AlwaysAbia/senior-project-freeuni/3d-models/JPEGs/BotPartCollapsed.JPG

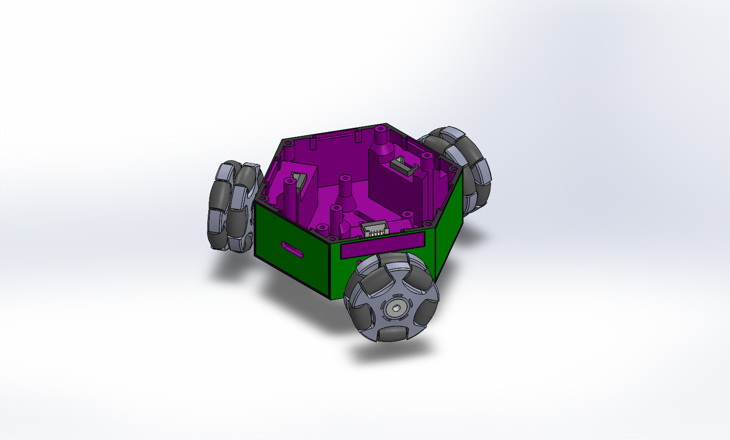
3d-models/JPEGs/BotPartCollapsed.JPG
