AlwaysAbia/senior-project-freeuni/3d-models/JPEGs/MidPartCollapsed.JPG

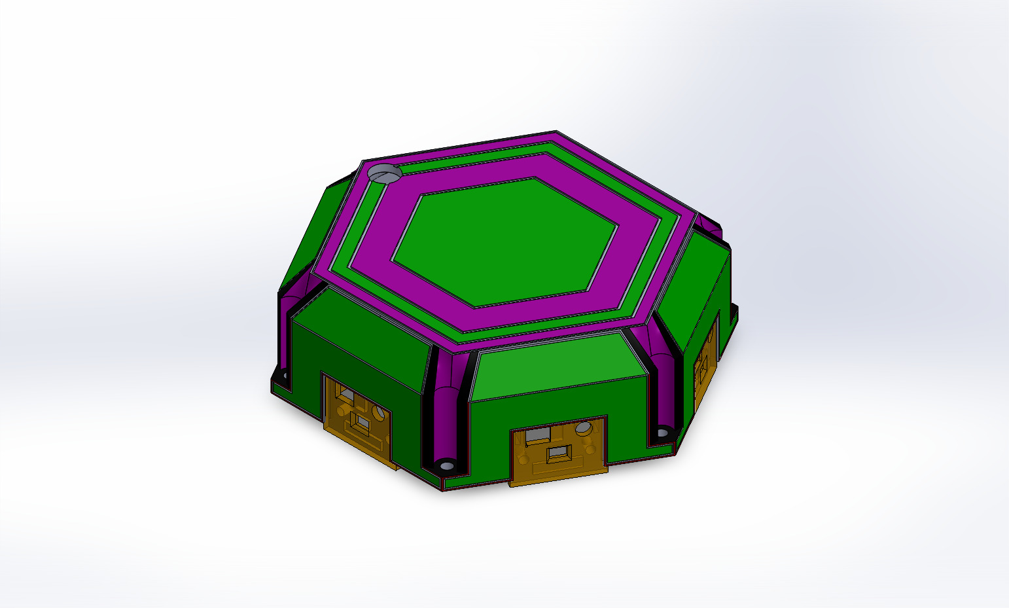
3d-models/JPEGs/MidPartCollapsed.JPG
