AlwaysAbia/senior-project-freeuni/3d-models/JPEGs/MidPartExploded.JPG

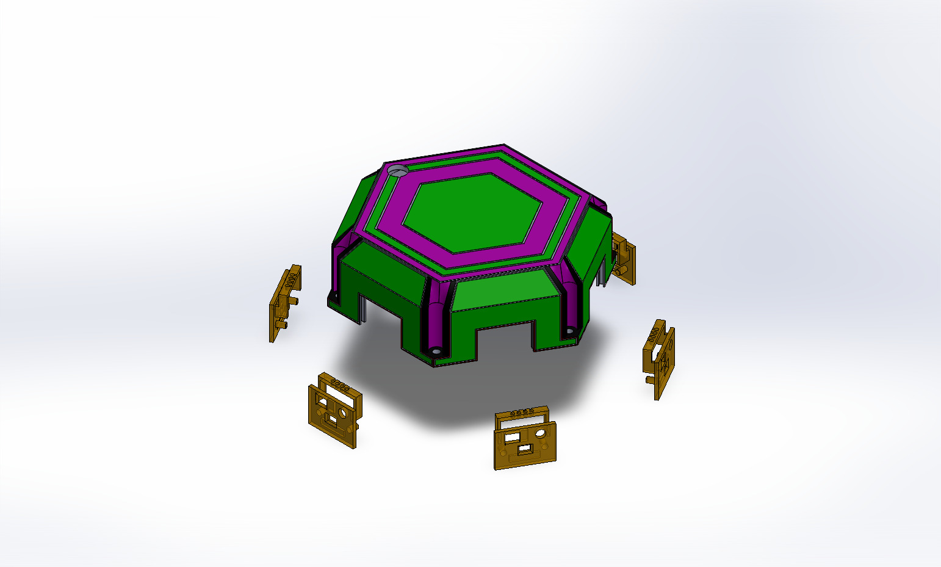
3d-models/JPEGs/MidPartExploded.JPG
