AlwaysAbia/senior-project-freeuni/3d-models/JPEGs/SensorModuleBotSide.JPG

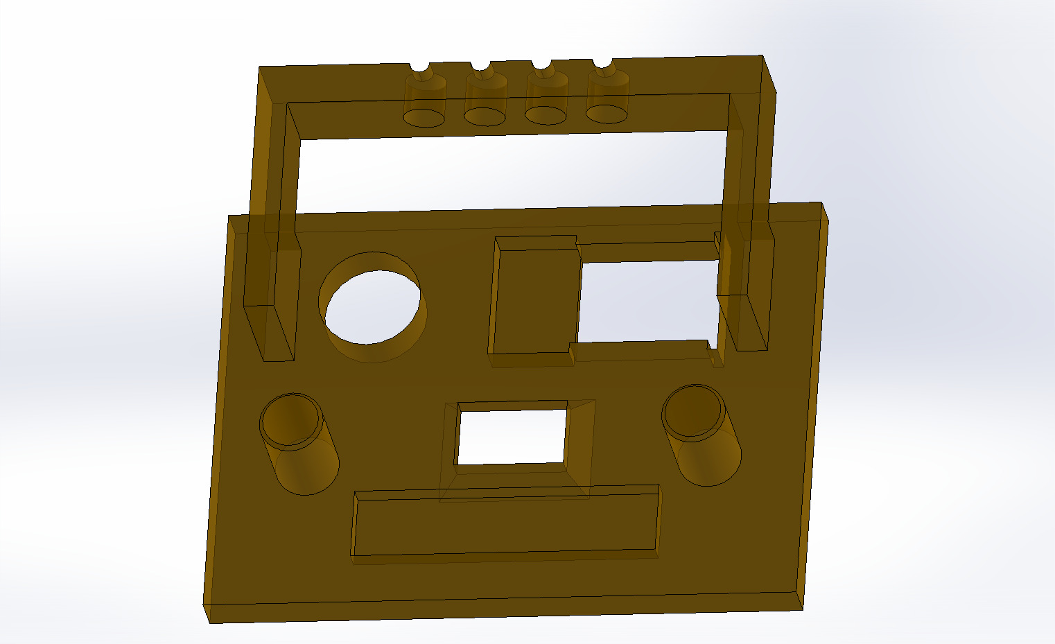
3d-models/JPEGs/SensorModuleBotSide.JPG
