AlwaysAbia/senior-project-freeuni/3d-models/JPEGs/SensorModuleTopSide.JPG

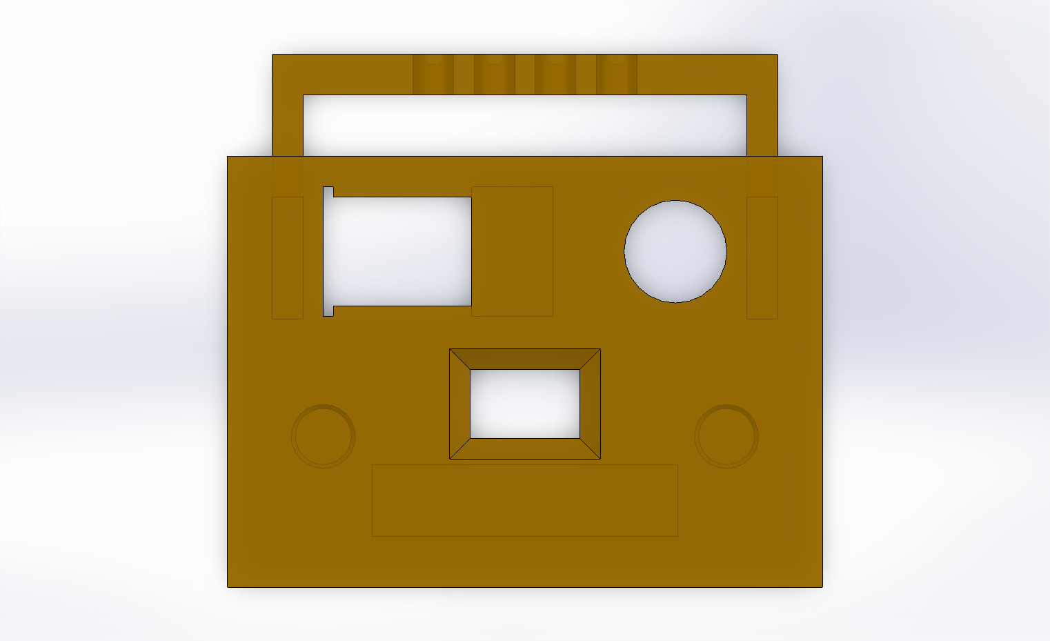
3d-models/JPEGs/SensorModuleTopSide.JPG
