AlwaysAbia/senior-project-freeuni/3d-models/FinalModels/MidPart.SLDPRT

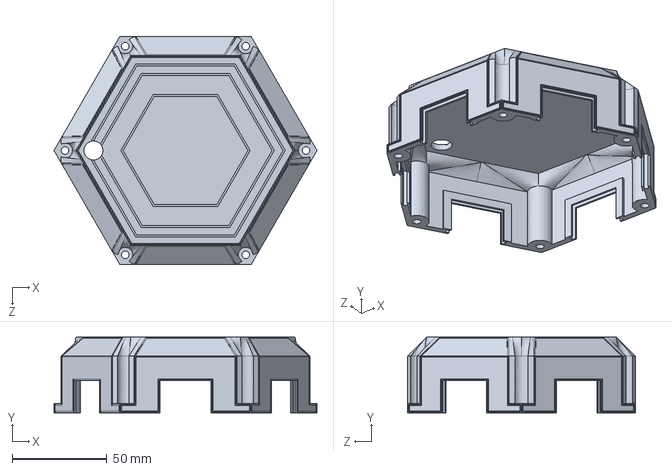
[picture p22: CAD file, 2025-06-16]
3d-models/FinalModels/MidPart.SLDPRT
138.6 x 40.0 x 120.0 mm
