AlwaysAbia/senior-project-freeuni/3d-models/FinalModels/SensorModule.SLDPRT

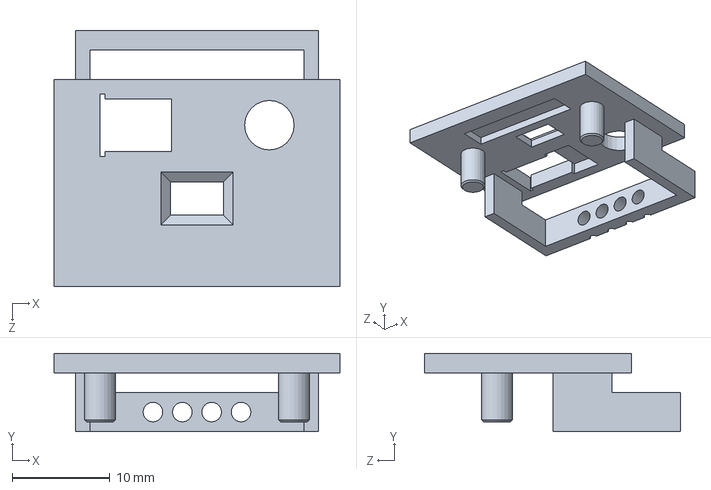
[picture p23: CAD file, 2025-06-16]
3d-models/FinalModels/SensorModule.SLDPRT
29.2 x 8.00 x 26.2 mm
