AlwaysAbia/senior-project-freeuni/3d-models/FinalModels/BotPartSTL.STL

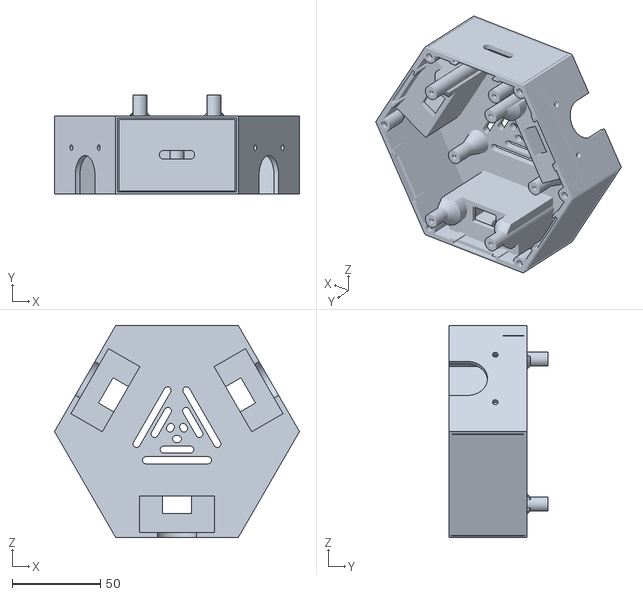
[picture p24: CAD file, 2025-06-16]
3d-models/FinalModels/BotPartSTL.STL
138.6 x 56.0 x 120.0
