AlwaysAbia/senior-project-freeuni/3d-models/FinalModels/TopPart.SLDPRT

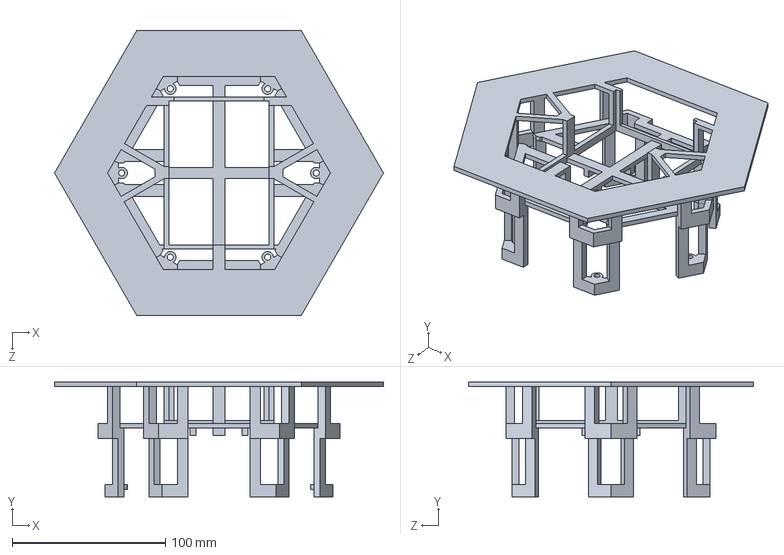
[picture p25: CAD file, 2025-06-16]
3d-models/FinalModels/TopPart.SLDPRT
214.8 x 75.0 x 186.0 mm
