AlwaysAbia/senior-project-freeuni/(list of files, cad)

Other CAD files:
3d-models/FinalModels/ModuleSTL.STL
3d-models/FinalModels/BotPart.SLDPRT
3d-models/FinalModels/MidPartSTL.STL
3d-models/FinalModels/TopPartSTL.STL
