AlwaysAbia/senior-project-freeuni/3d-models/JPEGs/FullAssemblyCollapsed.JPG

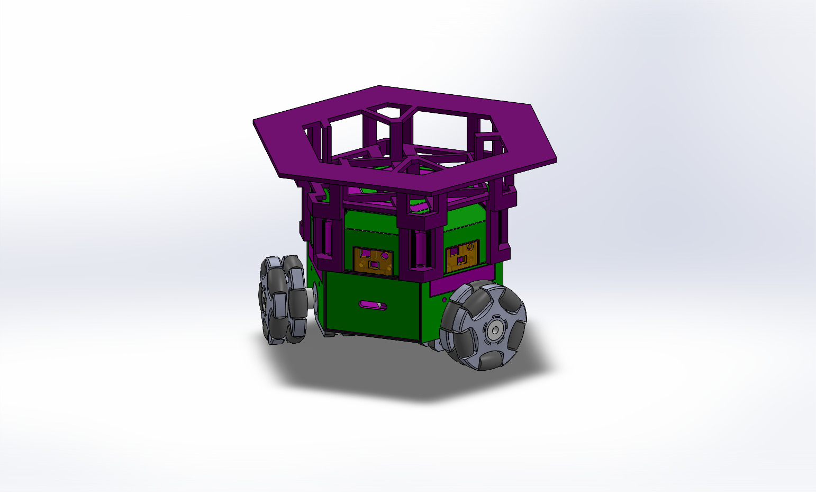
3d-models/JPEGs/FullAssemblyCollapsed.JPG
