AlwaysAbia/senior-project-freeuni/3d-models/JPEGs/FullAssemblyExploded.JPG

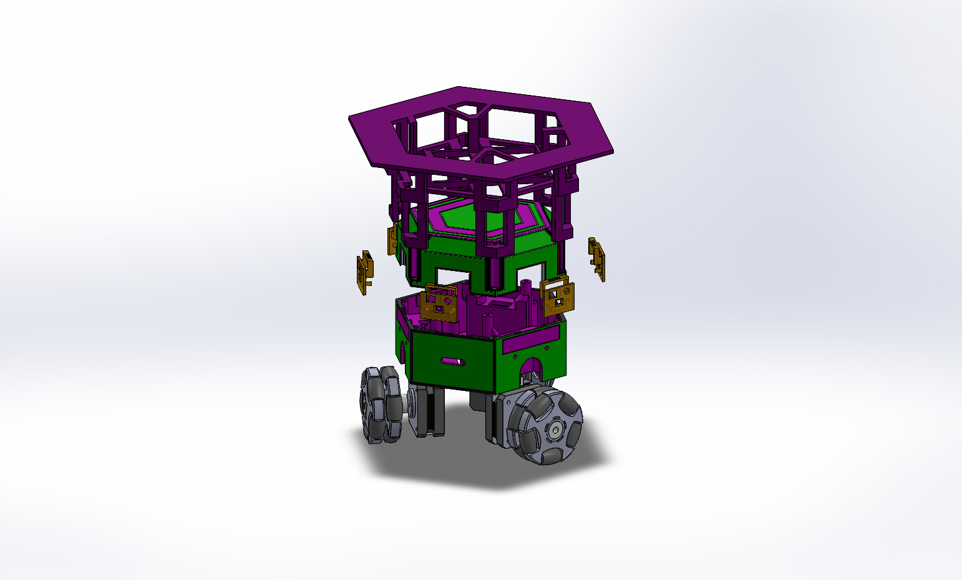
3d-models/JPEGs/FullAssemblyExploded.JPG
