AlwaysAbia/senior-project-freeuni/schematics-and-pcb/MainPCB/Schematic.pdf

IO12 20 IO13 21 IO14 22 IO21 23 IO47 24 IO48 25 IO45 26 IO0 27 IO35 28 IO36 29 IO37 30 IO38 31 IO39 32 IO40 33 IO41 34 IO42 35 RXD0 36 TXD0 37 IO2 38 IO1 39 GND 40 GND ⁴¹

# GNDESP_3V³

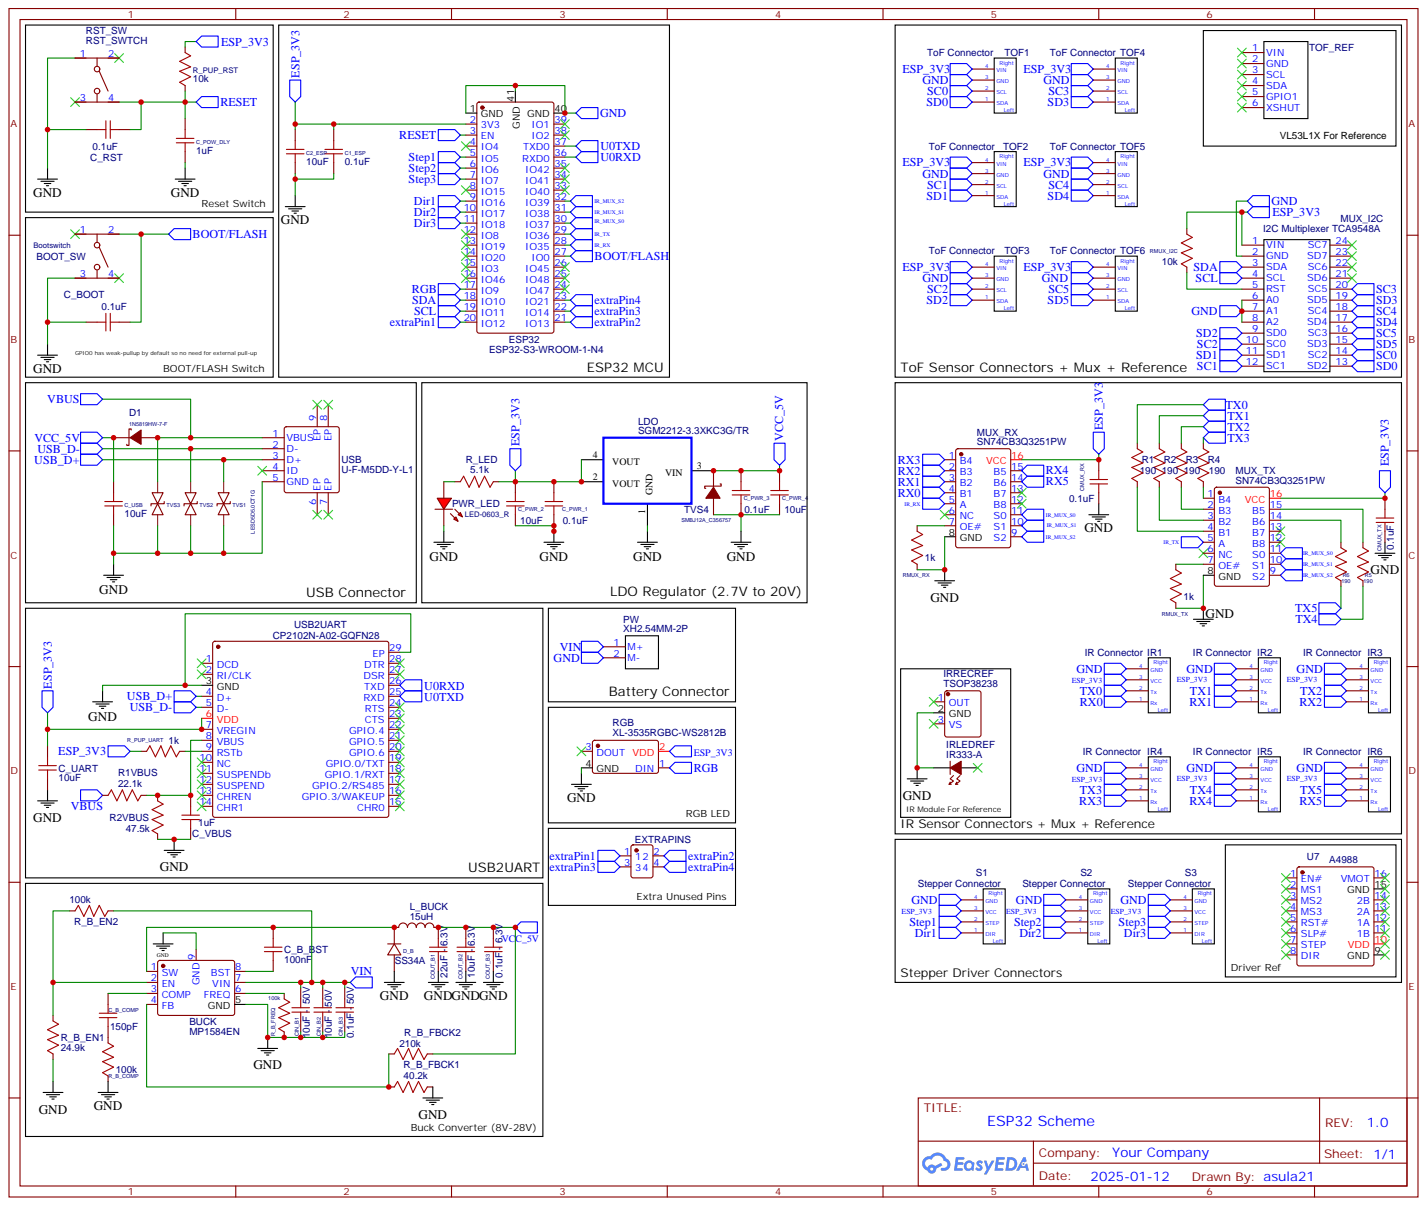
[picture p28: page 1]

GPIO0 has weak-pullup by default so no need for external pull-up

ToF Sensor Connectors + Mux + Reference

GND
IR Module For Reference
IR Sensor Connectors + Mux + Reference
