AlwaysAbia/senior-project-freeuni/schematics-and-pcb/MainPCB/PCB_Layout.pdf

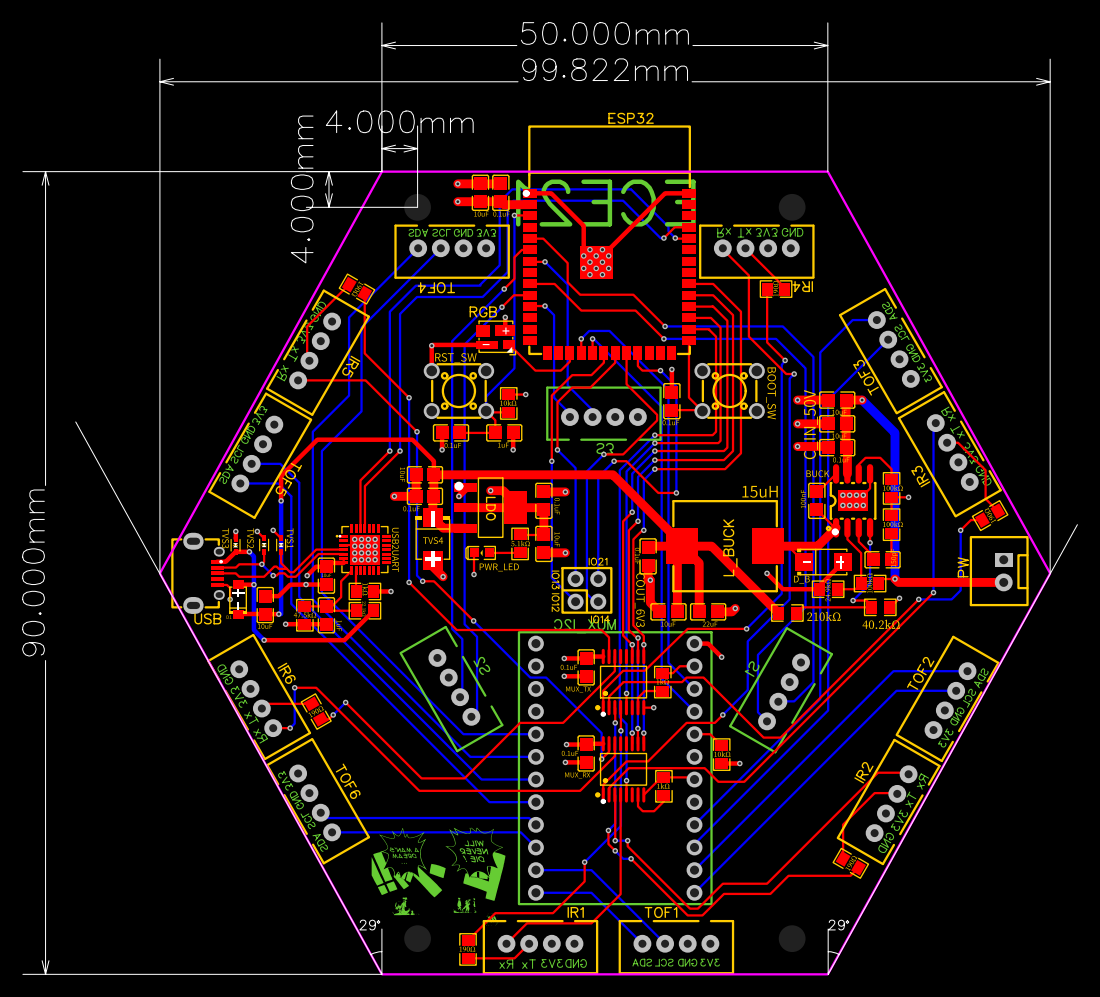
[picture p29: page 1]

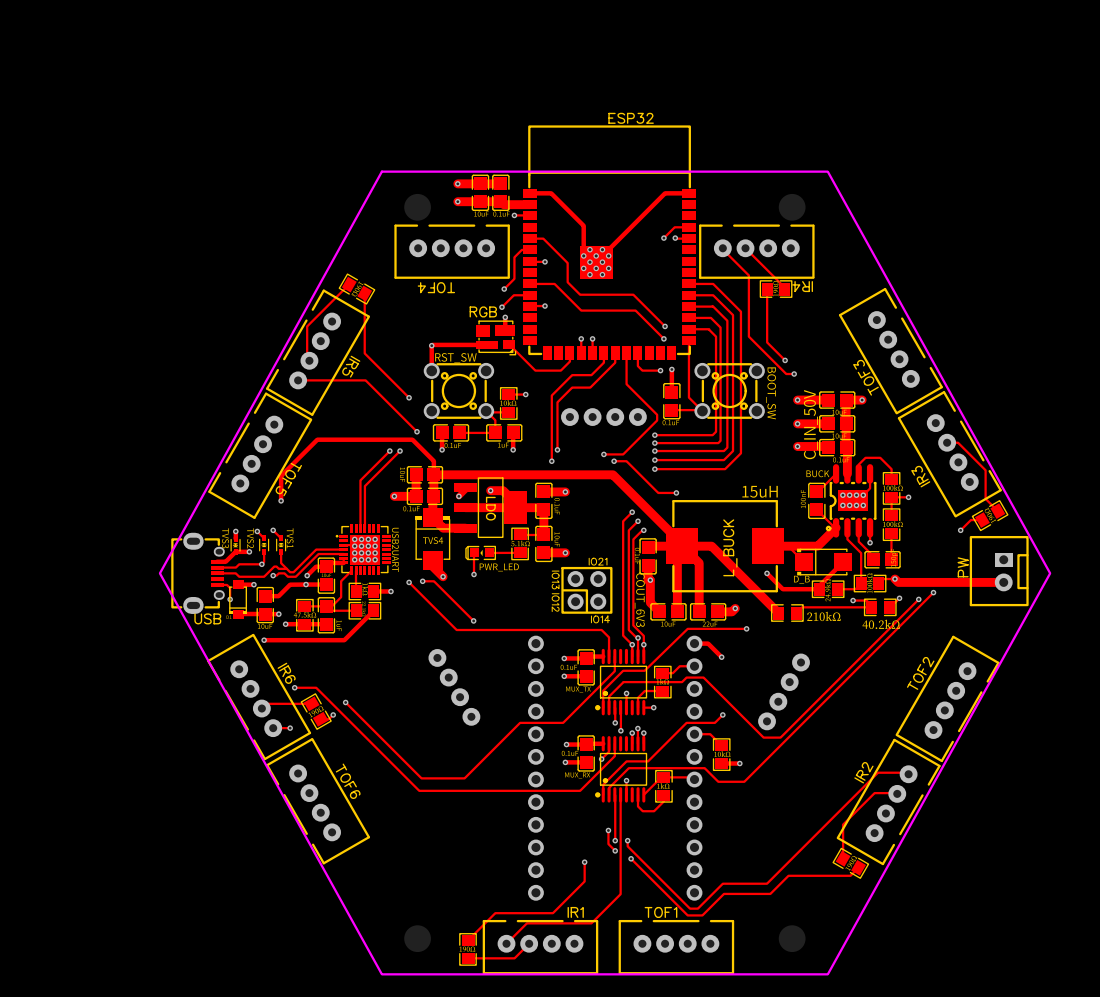
[picture p30: page 2]

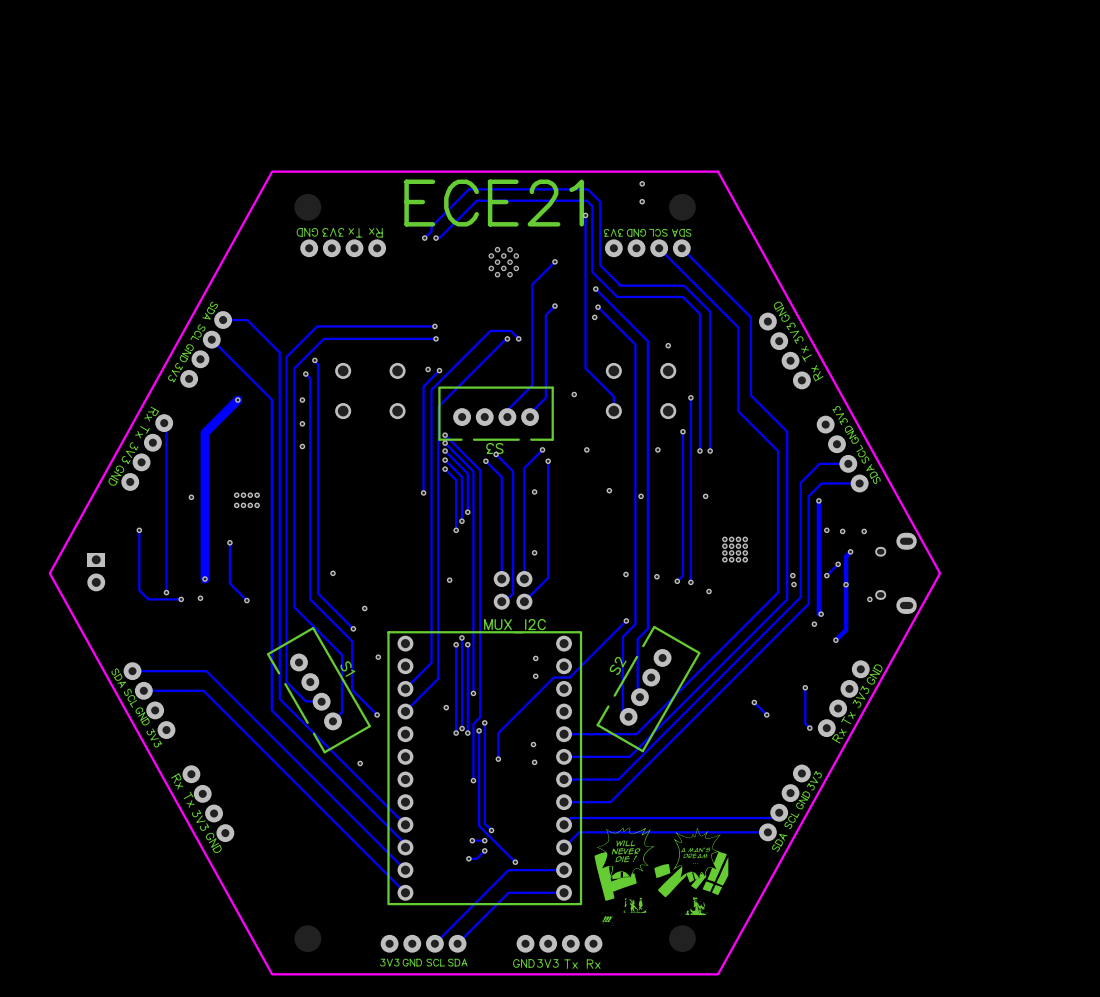
[picture p31: page 3]
