AlwaysAbia/senior-project-freeuni/schematics-and-pcb/MotorControlPCB/PCB_Layout.pdf

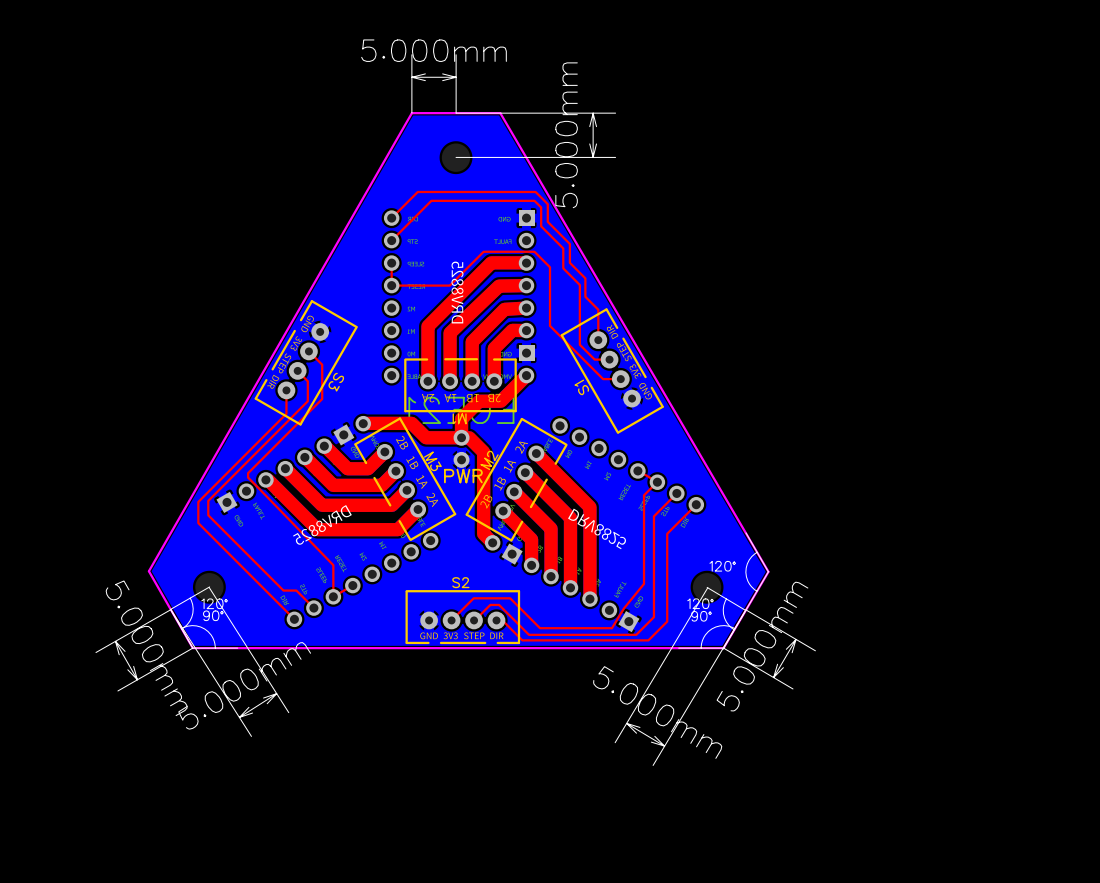
[picture p32: page 1]

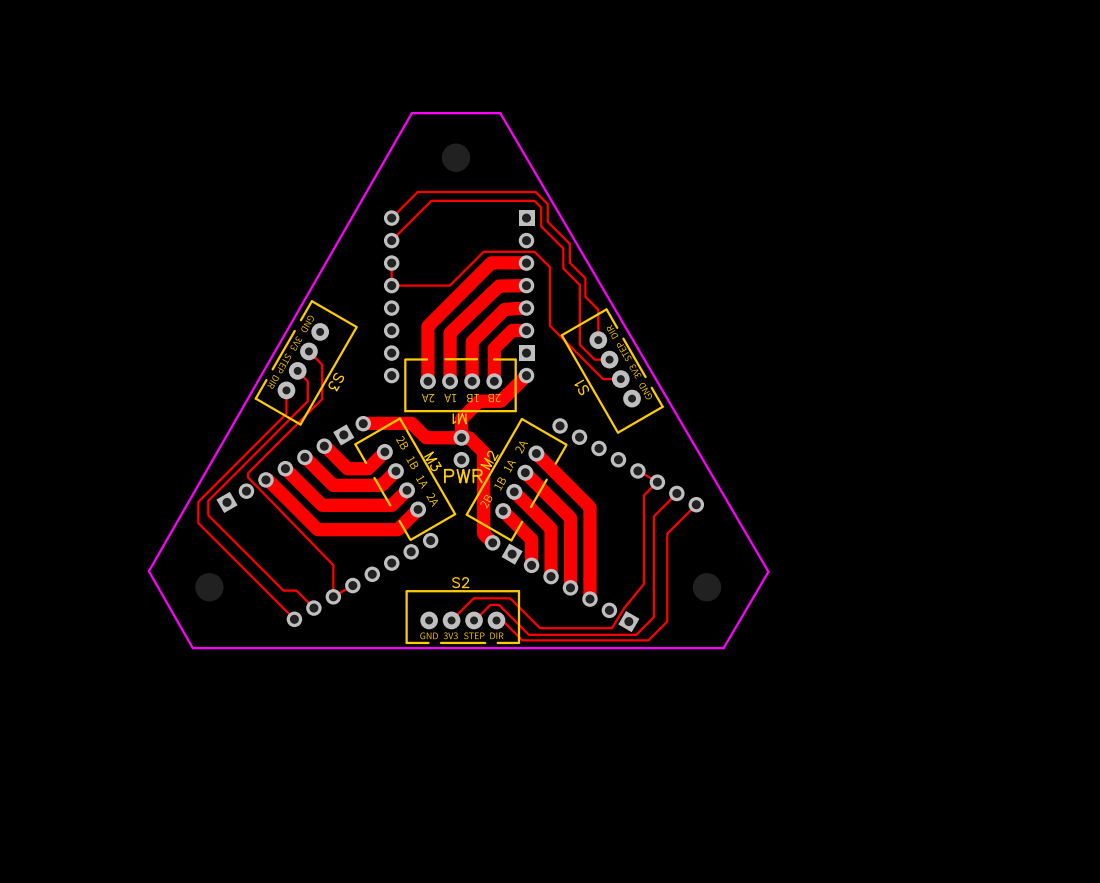
[picture p33: page 2]

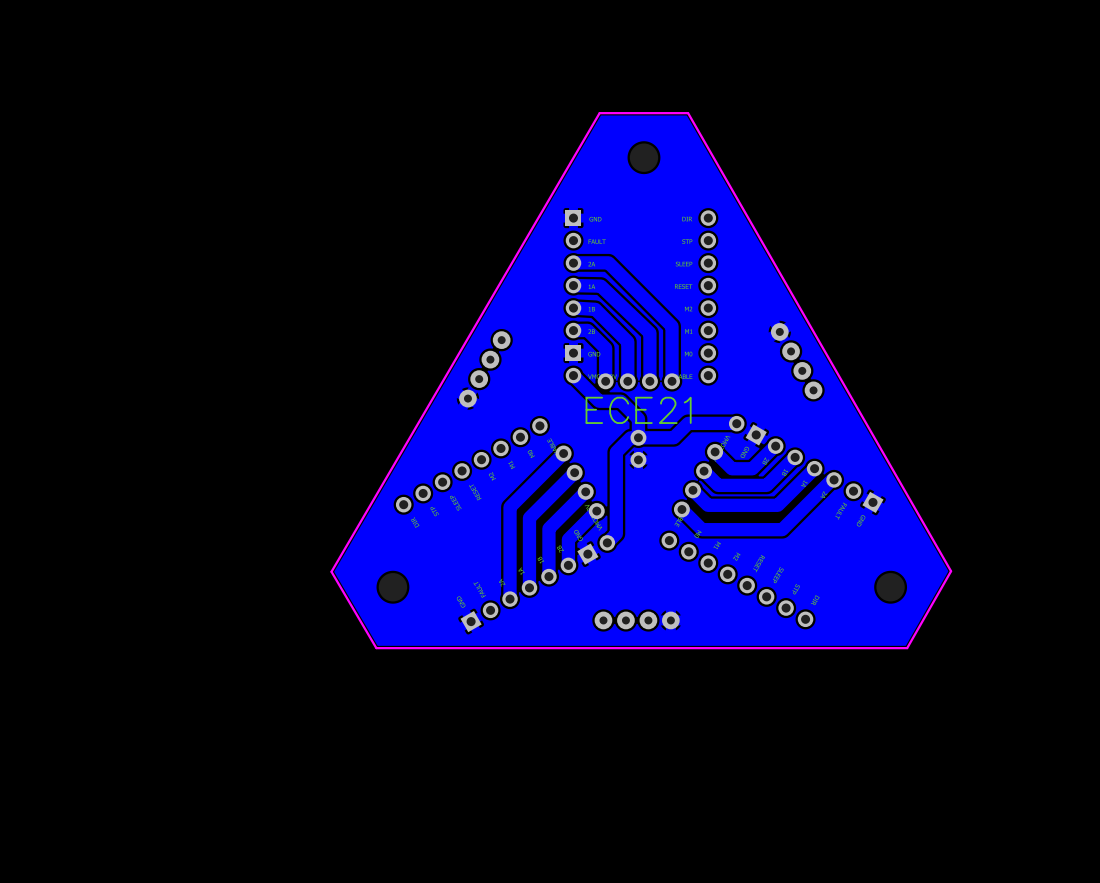
[picture p34: page 3]
