AlwaysAbia/senior-project-freeuni/(list of files, drawings)

Other design files:
schematics-and-pcb/MainPCB/PCB_EasyEDA.json
schematics-and-pcb/MainPCB/SCH_EasyEDA.json
schematics-and-pcb/MotorControlPCB/PCB_EasyEDA.json
