AlwaysAbia/senior-project-freeuni/RoboticSwarmSoftware/include/network_credentials.hpp

#ifndef NETWORK_CREDENTIALS_HPP
#define NETWORK_CREDENTIALS_HPP

//LAN Network Credentials
const char* ssid = "";
const char* password = "";

const char* hostname = "esp32_s3_2";
const char* otapassword = "sampleOTAPass";

//MQTT Credentials
const char* mqtt_broker = "";
const int mqtt_port = 1883; //Not using TLS
const char* mqtt_user = "";
const char* mqtt_password = "";

#endif
