AlwaysAbia/senior-project-freeuni/(commit log)

2025-03-15 Initial commit + Schematic v1.0
2025-03-16 add schematic v1.1 with readme
    [SCH_SrProj_v1.0.json, SCH_SrProj_v1.1.json]
2025-03-20 add v1.2
    [SCH_SrProj_v1.2.json]
2025-03-20 Schem v1.3 + PCB Layout
    [PCB_AlmostFinished.json, SCH_SrProj_v1.3.json]
2025-03-21 add v1.4
    [PCB_PCB_SrProj_v1.4.json, SCH_SrProj_v1.4.json]
2025-03-23 Add v1.5
    [PCB_PCB_SrProj_v1.5.json, SCH_SrProj_v1.5.json]
2025-03-23 Added v1.6 (v1 final)
    [PCB_PCB_SrProj_v1.6_final.json, SCH_SrProj_v1.6_final.json]
2025-04-08 Second PCB Layout
    [PCB_PCB2_SrProj_2025-04-08.json]
2025-04-08 Added latest prototype for the lower third of the robot
    [Prototype2.SLDPRT]
2025-04-17 Cleaned up Repo, added Second PCB
    [PCB_AlmostFinished.json, PCB_EasyEDA.json, PCB_PCB2_SrProj_2025-04-08.json, PCB_PCB_SrProj_v1.4.json, PCB_PCB_SrProj_v1.5.json, PCB_PCB_SrProj_v1.6_final.json, SCH_SrProj_v1.0.json, SCH_SrProj_v1.1.json]
2025-04-17 more cleanup
    [PCB_EasyEDA.json, SCH_EasyEDA.json]
2025-04-17 add sensorModule 3D model
    [Module.SLDPRT, ModuleV5.STL]
2025-06-16 Added 3d models
    [BotPart.SLDPRT, BotPartSTL.STL, MidPart.SLDPRT, MidPartSTL.STL, Module.SLDPRT, ModuleSTL.STL, ModuleV5.STL, Prototype2.SLDPRT]
2025-10-19 Added new GUI version
    [Module.SLDPRT, ModuleV5.STL, Prototype2.SLDPRT]
2025-10-19 refactored 3d-models directory
    [BotPart.SLDPRT, BotPartSTL.STL, MidPart.SLDPRT, MidPartSTL.STL, Module.SLDPRT, ModuleSTL.STL, ModuleV5.STL, Prototype2.SLDPRT]
